ckitagawa/NE2019_FYDP/README.md

# NE2019_FYDP
Fiber Optic Tactile/Pressure Sensor: Nanotechonology Engineering Fourth Year Design Project 2019
