ckitagawa/NE2019_FYDP/hardware/main_board/main.kicad_pcb

## KiCad design hardware/main_board/main.kicad_pcb (2019-02-24)

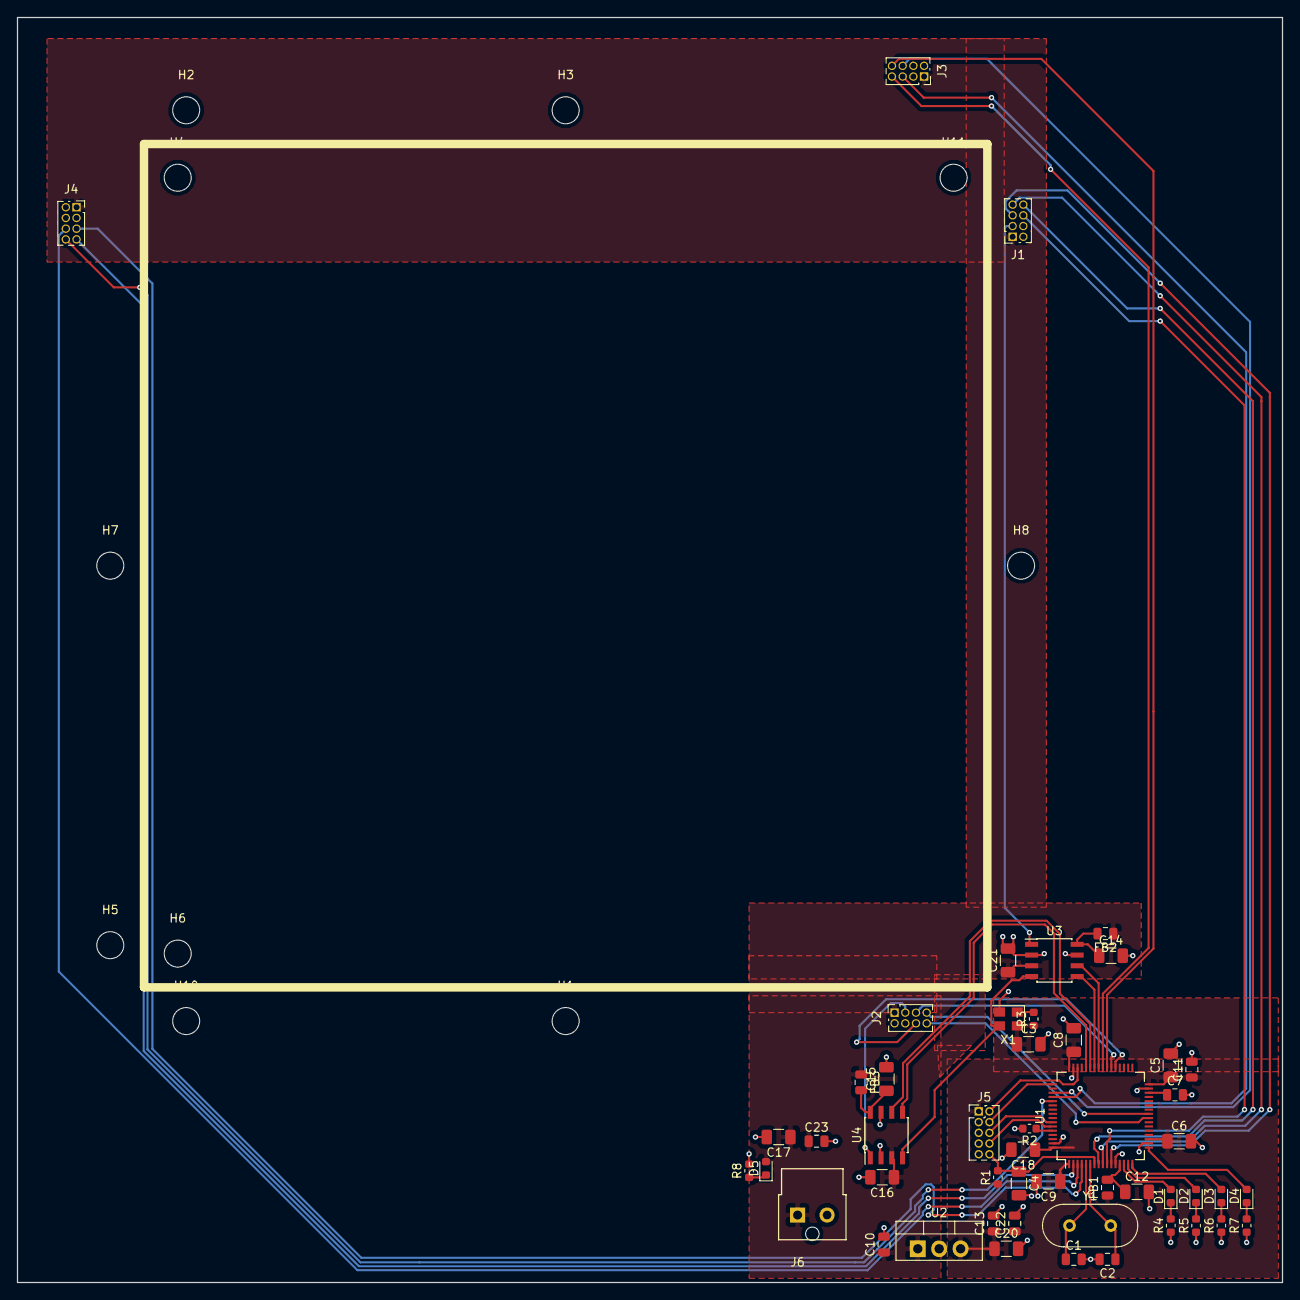
[picture p1: board main.kicad_pcb from above]

Board: 2 copper layers, 150.0 x 150.0 mm, 60 parts (0 on the bottom side), 48 nets.

Parts:
C1, C2: 30 pF; C_0805_2012Metric
C3, C4, C5, C6, C8, C9, C12, C14, C15, C16, C17, C18, C20, C21: 100 nF; C_1206_3216Metric
C7, C11, C22, C23: 4.7 uF; C_0805_2012Metric
C10, C13: 1 uF; C_0805_2012Metric
D1: Green; LED_0603_1608Metric
D2: Red; LED_0603_1608Metric
D3, D4: Yellow; LED_0603_1608Metric
D5: LED; LED_0603_1608Metric
FB1, FB2, FB3: Ferrite_Bead; L_0805_2012Metric
H1, H2, H3, H4, H5, H6, H7, H8, H10, H11: MountingHole; MountingHole_3.2mm_M3
J1, J2, J3, J4: Conn_02x04_Counter_Clockwise; PinSocket_2x04_P1.27mm_Vertical
J5: Conn_02x05_Odd_Even; PinHeader_2x05_P1.27mm_Vertical
J6: Conn_01x02_Female; Ultra-Fit 2 Pin 3.5 mm
R1: 100k; R_0603_1608Metric
R2: 510; R_0603_1608Metric
R3: 10k; R_0603_1608Metric
R4, R5, R6, R7, R8: 180; R_0603_1608Metric
U1: STM32F410RBTx; LQFP-64_10x10mm_P0.5mm
U2: SPX1117M3-L-3-3/TR; TO-220-3_Vertical
U3, U4: ADS1252; SOIC-8_3.9x4.9mm_P1.27mm
X1: ECS-2333; Oscillator_SMD_Abracon_ASE-4Pin_3.2x2.5mm
Y1: 16 MHz; Crystal_HC49-U_Vertical

Connections:
+3V3: C3.1, C5.1, C6.1, C8.1, C9.1, C11.1, C13.1, C18.1, C20.1, C22.1, FB1.1, J5.1, R1.1, R3.1, U1.1, U1.19, U1.32, U1.48, U1.64, U2.3, X1.4
+5V: C10.1, C16.1, C17.1, C21.1, C23.1, D5.2, FB2.1, FB3.1, J1.1, J2.1, J3.1, J4.1, J6.1, U2.1, U3.3, U4.3
DATA1: U1.42, U3.5
DATA2: U1.44, U4.5
GND: C1.2, C2.2, C3.2, C4.2, C5.2, C6.2, C7.2, C8.2, C9.2, C10.2, C11.2, C12.2, C13.2, C14.2, C15.2, C16.2, C17.2, C18.2, C20.2, C21.2, C22.2, C23.2, J1.2, J1.4, J2.2, J2.4, J3.2, J3.3, J3.4, J4.2, J4.3, J4.4, J5.3, J5.5, J6.2, R2.2, R4.1, R5.1, R6.1, R7.1, R8.2, U1.12, U1.18, U1.31, U1.47, U1.63, U2.2, U3.2, U3.7, U4.2, U4.7, X1.2
IN1: J1.3, U3.1
IN2: J2.3, U4.1
NRST: C4.1, J5.10, R1.2, U1.7
unnamed: C7.1, U1.30
unnamed: C12.1, FB1.2, U1.13
unnamed: C14.1, FB2.2, U3.8
unnamed: C15.1, FB3.2, U4.8
unnamed: D1.1, R4.2
unnamed: D2.1, R5.2
unnamed: D3.1, R6.2
unnamed: D4.1, R7.2
unnamed: D5.1, R8.1
unnamed: J1.5, U1.11
unnamed: J1.6, U1.10
unnamed: J1.7, U1.9
unnamed: J1.8, U1.8
unnamed: J2.5, U1.38
unnamed: J2.6, U1.37
unnamed: J2.7, U1.25
unnamed: J2.8, U1.24
unnamed: J3.5, U1.52
unnamed: J3.6, U1.51
unnamed: J3.7, U1.40
unnamed: J3.8, U1.39
unnamed: J4.5, U1.4
unnamed: J4.6, U1.3
unnamed: J4.7, U1.2
unnamed: J4.8, U1.53
unnamed: R2.1, U1.60
unnamed: R3.2, X1.1
unnamed: U3.4, U4.4, X1.3
OSC_IN: C1.1, U1.5, Y1.1
OSC_OUT: C2.1, U1.6, Y1.2
PA0: D1.2, U1.14
PA1: D2.2, U1.15
PA2: D3.2, U1.16
PA3: D4.2, U1.17
SCLK1: U1.41, U3.6
SCLK2: U1.43, U4.6
SWCLK: J5.4, U1.49
SWDIO: J5.2, U1.46
USART1_RX: J5.8, U1.59
USART1_TX: J5.6, U1.58
