ckitagawa/NE2019_FYDP/hardware/led/LED PCB.kicad_pcb

## KiCad design hardware/led/LED PCB.kicad_pcb (2019-02-24)

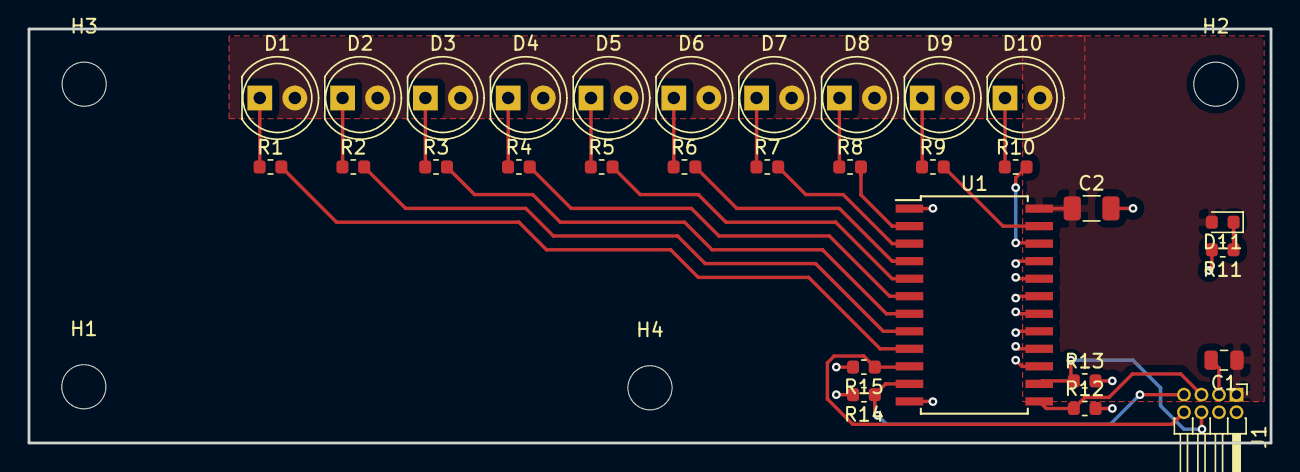
[picture p2: board LED PCB.kicad_pcb from above]

Board: 2 copper layers, 90.0 x 30.0 mm, 34 parts (0 on the bottom side), 27 nets.

Parts:
C1: 4.7 uF; C_0805_2012Metric
C2: 100 nF; C_1206_3216Metric
D1, D2, D3, D4, D5, D6, D7, D8, D9, D10: LED; LED_D5.0mm_Clear
D11: LED; LED_0603_1608Metric
H1, H2, H3, H4: MountingHole; MountingHole_3.2mm_M3
J1: Conn_02x04_Counter_Clockwise; PinHeader_2x04_P1.27mm_Horizontal
R1, R2, R3, R4, R5, R6, R7, R8, R9, R10: 125; R_0603_1608Metric
R11: 180; R_0603_1608Metric
R12, R13, R14, R15: 10k; R_0603_1608Metric
U1: CD74HC4067M; SOIC-24W_7.5x15.4mm_P1.27mm

Connections:
+5V: C1.1, C2.1, D1.2, D2.2, D3.2, D4.2, D5.2, D6.2, D7.2, D8.2, D9.2, D10.2, D11.2, J1.1, U1.24
GND: C1.2, C2.2, J1.2, J1.3, J1.4, R11.2, R12.2, R13.2, R14.2, R15.2, U1.1, U1.12, U1.15, U1.16, U1.17, U1.18, U1.19, U1.20, U1.21
unnamed: D1.1, R1.1
unnamed: D2.1, R2.1
unnamed: D3.1, R3.1
unnamed: D4.1, R4.1
unnamed: D5.1, R5.1
unnamed: D6.1, R6.1
unnamed: D7.1, R7.1
unnamed: D8.1, R8.1
unnamed: D9.1, R9.1
unnamed: D10.1, R10.1
unnamed: D11.1, R11.1
unnamed: R1.2, U1.9
unnamed: R2.2, U1.8
unnamed: R3.2, U1.7
unnamed: R4.2, U1.6
unnamed: R5.2, U1.5
unnamed: R6.2, U1.4
unnamed: R7.2, U1.3
unnamed: R8.2, U1.2
unnamed: R9.2, U1.23
unnamed: R10.2, U1.22
S0: J1.8, R15.1, U1.10
S1: J1.7, R14.1, U1.11
S2: J1.6, R13.1, U1.14
S3: J1.5, R12.1, U1.13
