ckitagawa/NE2019_FYDP/hardware/photodiode/fydp.kicad_pcb

## KiCad design hardware/photodiode/fydp.kicad_pcb (2019-02-24)

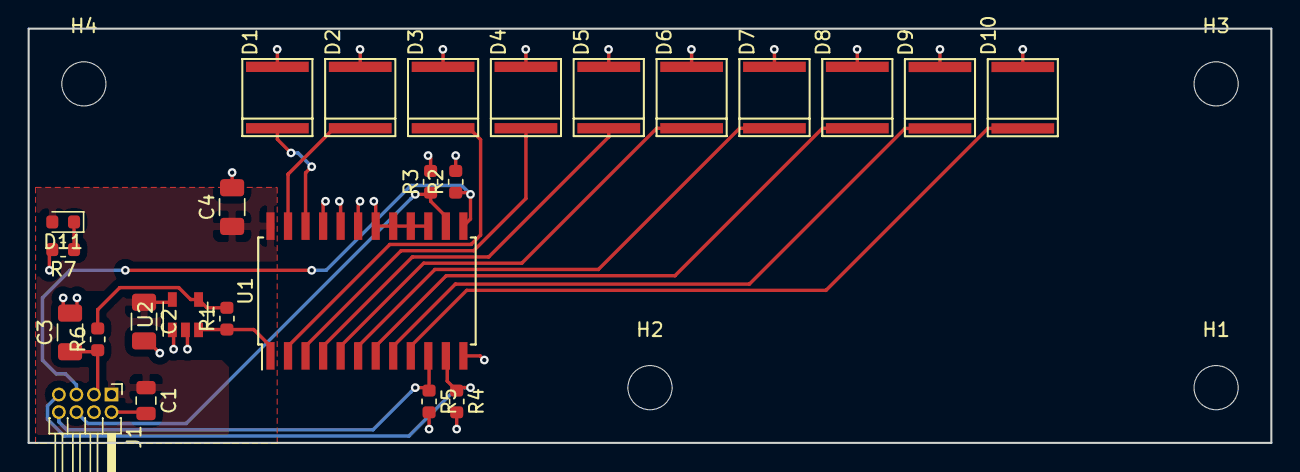
[picture p3: board fydp.kicad_pcb from above]

Board: 2 copper layers, 90.0 x 30.0 mm, 29 parts (0 on the bottom side), 20 nets.

Parts:
C1: 4.7 uF; C_0805_2012Metric
C2, C4: 100 nF; C_1206_3216Metric
C3: 47 nF; C_1206_3216Metric
D1, D2, D3, D4, D5, D6, D7, D8, D9, D10: D_Photo; PDB-C171SM
D11: LED; LED_0603_1608Metric
H1, H2, H3, H4: MountingHole; MountingHole_3.2mm_M3
J1: Conn_02x04_Counter_Clockwise; PinHeader_2x04_P1.27mm_Horizontal
R1: 1.5M; R_0603_1608Metric
R2, R3, R4, R5: 10k; R_0603_1608Metric
R6: 800; R_0603_1608Metric
R7: 180; R_0603_1608Metric
U1: CD74HC4067M; SOIC-24W_7.5x15.4mm_P1.27mm
U2: LM321; SOT-23-5

Connections:
+5V: C1.1, C2.1, C4.1, D11.2, J1.1, U1.24, U2.5
COM: R1.1, U1.1, U2.3
GND: C1.2, C2.2, C3.2, C4.2, D1.2, D2.2, D3.2, D4.2, D5.2, D6.2, D7.2, D8.2, D9.2, D10.2, J1.2, J1.4, R2.2, R3.2, R4.2, R5.2, R7.2, U1.12, U1.15, U1.16, U1.17, U1.18, U1.19, U1.20, U1.21, U2.1, U2.2
unnamed: D1.1, U1.22
unnamed: D2.1, U1.23
unnamed: D3.1, U1.2
unnamed: D4.1, U1.3
unnamed: D5.1, U1.4
unnamed: D6.1, U1.5
unnamed: D7.1, U1.6
unnamed: D8.1, U1.7
unnamed: D9.1, U1.8
unnamed: D10.1, U1.9
unnamed: D11.1, R7.1
unnamed: R1.2, R6.2, U2.4
PD_out: C3.1, J1.3, R6.1
S0: J1.8, R5.1, U1.10
S1: J1.7, R4.1, U1.11
S2: J1.6, R3.1, U1.14
S3: J1.5, R2.1, U1.13
