ckitagawa/NE2019_FYDP/(commit log)

2019-02-24 00 - Initial Commit
    [stm32f4-openocd.cfg]
2019-02-24 02 - Add hardware (KiCad) and start of UI code
    [LED PCB-B.Cu.gbl, LED PCB-B.Mask.gbs, LED PCB-B.SilkS.gbo, LED PCB-Edge.Cuts.gm1, LED PCB-F.Cu.gtl, LED PCB-F.Mask.gts, LED PCB-F.SilkS.gto, LED PCB-job.gbrjob]
2019-02-26 04 - Fix NVIC Controller
    [main.c]
2019-03-01 07 - Improve python script and fix ADC (slight instability)
    [main.sch]
2019-03-02 08 - Fix up GUI
    [gui.py, main.py]
2019-03-03 09 - Improve device readings and streamline output.
2019-03-05 10 - Fix pinout, ui render and timing
    [main.c, main.py]
2019-03-05 11 - Fix calibration routine
    [main.c]
2019-03-18 Polyfit noise removal, fft graph, colour bar temp fix, graphical debugging
    [Generate_Test_Data.py, gui.py, main.py]
